JitterCompany/2401-mailbox-sensor/2401-pcb/design-calculations.xls

feedback resistor (Ohm) | 10000000 | 10M
wanted bandwidth (Hz) | 1000 | 1kHz
feedback capacitor (F) | 1.591549431e-11 | 15pF
photodiode capacitance (F) | 1.35e-10 | 23pF / 135pF
opamp input capacitance (F) | 1e-11 | estimate: 10pF
total input capacitance (F) | 1.45e-10
Opamp GBW required (Hz) | 10110.62 | Just > 10kHz !
