JitterCompany/2401-mailbox-sensor/2401-pcb/2401-pcb.xlsx

Sync | Ref | Qty | Value | Footprint | Description | MPN | Farnell | Mouser | required | stock | 3
1 | BT1, | 1 | SMTU 2450N-1-LF | Jitter_Footprints:BatteryHolder_SMTU-2450N-1-LF_1x2450 | Single-cell battery | SMTU 2450N-1-LF | 1216356 |  | 3
1 | C5, | 1 | 10uF | Capacitor_SMD:CP_Elec_4x5.4 | Polarized capacitor, small US symbol | MCVKZ035M100DA1L | 2611336 |  | 3
1 | C10, C17, | 2 | 15pF | Capacitor_SMD:C_0603_1608Metric | Unpolarized capacitor, small symbol |  | 721980 |  | 6
1 | C12, C11, C13, C2, C23, | 5 | 4.7uF | Capacitor_SMD:C_0805_2012Metric | Unpolarized capacitor, small symbol |  | 2611942 |  | 15
1 | C15, C14, C19, C24, C1, C6, C21, C22, C20, C16, C18, C7, C3, C4, C8, C9, | 16 | 100nF | Capacitor_SMD:C_0603_1608Metric | Unpolarized capacitor, small symbol |  | 2821266 |  | 48
1 | D1, | 1 | SFH2716 | Diode_SMD:D_0805_2012Metric | Photodiode | SFH 2716 | 2981722 |  | 3
1 | D2, | 1 | SFH2440 | OptoDevice:Osram_SMD-DIL2_4.5x4.0mm | Silicon Photodiode with V? Characteristic, SMD package | SFH 2440 | 2981709 |  | 3
1 | D3, | 1 | Red | LED_SMD:LED_0805_2012Metric | Light emitting diode | KPT-2012EC | 2099236 |  | 3
1 | D4, | 1 | Green | LED_SMD:LED_0805_2012Metric | Light emitting diode | KP-2012LSGC | 2463991 |  | 3
1 | J1, | 1 | Load Cell | Jitter_Footprints:JST_PH_S4B-PH-SM4-TB_1x04-1MP_P2.00mm_Horizontal | Generic connectable mounting pin connector, single row, 01x04, script generated (kicad-library-utils/schlib/autogen/connector/) | S4B-PH-SM4-TB(LF)(SN) | 9492631 |  | 0 | 8
1 | J2, | 1 | JTAG/SWD | Jitter_Footprints:connector_jtag_10pin_shrouded | Cortex Debug Connector, standard ARM Cortex-M SWD and JTAG interface | 20021521-00010T1LF |  |  | 0 | 100
1 | J3, | 1 | Conn_01x04_Male | Connector_PinHeader_2.54mm:PinHeader_1x04_P2.54mm_Vertical | Generic connector, single row, 01x04, script generated (kicad-library-utils/schlib/autogen/connector/) |  |  |  | 0 | 20
1 | Q1, | 1 | SFH3710(-Z) | Diode_SMD:D_0805_2012Metric_Pad1.15x1.40mm_HandSolder | NPN phototransistor, collector/emitter | SFH3710-Z | 2981749 |  | 3 |  | 2 versies van deze phototransistor: evt vergelijken
1 | Q2, | 1 | SFH3710 | Diode_SMD:D_0805_2012Metric_Pad1.15x1.40mm_HandSolder | NPN phototransistor, collector/emitter | SFH3710 | 1573490 |  | 3
1 | R2, R1, R6, R14, | 4 | 10M | Resistor_SMD:R_0805_2012Metric_Pad1.15x1.40mm_HandSolder | Resistor |  | 2447555 |  | 12
1 | R7, R8, | 2 | 4k7 | Resistor_SMD:R_0805_2012Metric_Pad1.15x1.40mm_HandSolder | Resistor |  | 2447672 |  | 6
1 | R9, R10, R4, R3, | 4 | 47k | Resistor_SMD:R_0805_2012Metric_Pad1.15x1.40mm_HandSolder | Resistor |  | 2447664 |  | 12
1 | R11, R12, | 2 | 150 | Resistor_SMD:R_0805_2012Metric_Pad1.15x1.40mm_HandSolder | Resistor |  | 2447574 |  | 6
1 | R13, R15, | 2 | 0 | Resistor_SMD:R_0805_2012Metric_Pad1.15x1.40mm_HandSolder | Resistor |  | 9333681 |  | 6
1 | RV1, | 1 | 100Ω | Potentiometer_SMD:Potentiometer_Bourns_3314J_Vertical | Potentiometer | 3314J-2-101E | 2328505 |  | 3
1 | RV2, | 1 | 100KΩ | Potentiometer_SMD:Potentiometer_Bourns_3314J_Vertical | Potentiometer | 3314J-2-104E | 2328506 |  | 3
1 | SW1, | 1 | SW_SPDT | Jitter_Footprints:slide_switch_09.03201.02 | Switch, single pole double throw | 09.03201.02 | 1608080 |  | 3
1 | U1, | 1 | LIS3DHTR | Package_LGA:LGA-16_3x3mm_P0.5mm_LayoutBorder3x5y | 3-Axis Accelerometer, 2/4/8/16g range, I2C/SPI interface, LGA-16 | LIS3DHTR | 2253507 | 511-LIS3DHTR | 3
1 | U2, | 1 | VL6180X | Jitter_Footprints:VL6180X | Proximity and ambient light sensing (ALS) module | VL6180XV0NR/1 | 2462820 |  | 3
1 | U3, | 1 | INA126 | Package_SO:VSSOP-8_3.0x3.0mm_P0.65mm |  | INA126E | 3004490 |  | 3
1 | U5, | 1 | DPS422 | Package_LGA:Bosch_LGA-8_2x2.5mm_P0.65mm_ClockwisePinNumbering | Barometric pressure & temp sensor | DPS422XTSA1 | 2986299 |  | 3
1 | U7, | 1 | TLV70228_SOT23-5 | Package_TO_SOT_SMD:SOT-23-5 | 300mA Low Dropout Voltage Regulator, Fixed Output 2.8V, SOT-23-5 | TLV70228DBVT | 2492371 |  | 3
1 | U8, | 1 | STM32G070KBT6 | Package_QFP:LQFP-32_7x7mm_P0.8mm | ARM Cortex-M0+ MCU, 128KB flash, 36KB RAM, 64MHz, 2.0-3.6V, 29 GPIO, LQFP-32 ARM Cortex-M0 MCU, 64KB flash, 8KB RAM, 48MHz, 2.4-3.6V, 39 GPIO, LQFP-48 | STM32G070KBT6 | 3365394 | 511-STM32G070KBT6 | 3
1 | U9, | 1 | AT25SF641-SUB-T | Package_SO:SOIC-8_3.9x4.9mm_P1.27mm | 64-Mbit, 2.5V Minimum SPI Serial Flash Memory with Dual-I/O and Quad-I/O Support, SOIC-8 | AT25SF641-SUB-T | 2988514 |  | 3
1 | U11, U6, U10, U4, | 4 | MCP6001U | Package_TO_SOT_SMD:SOT-23-5 | 1MHz, Low-Power Op Amp, SOT-23-5 | MCP6001U | 8540845 |  | 12
