JitterCompany/2401-mailbox-sensor/2401-pcb/2401-pcb.kicad_pcb

## KiCad design 2401-pcb/2401-pcb.kicad_pcb (2020-06-11)

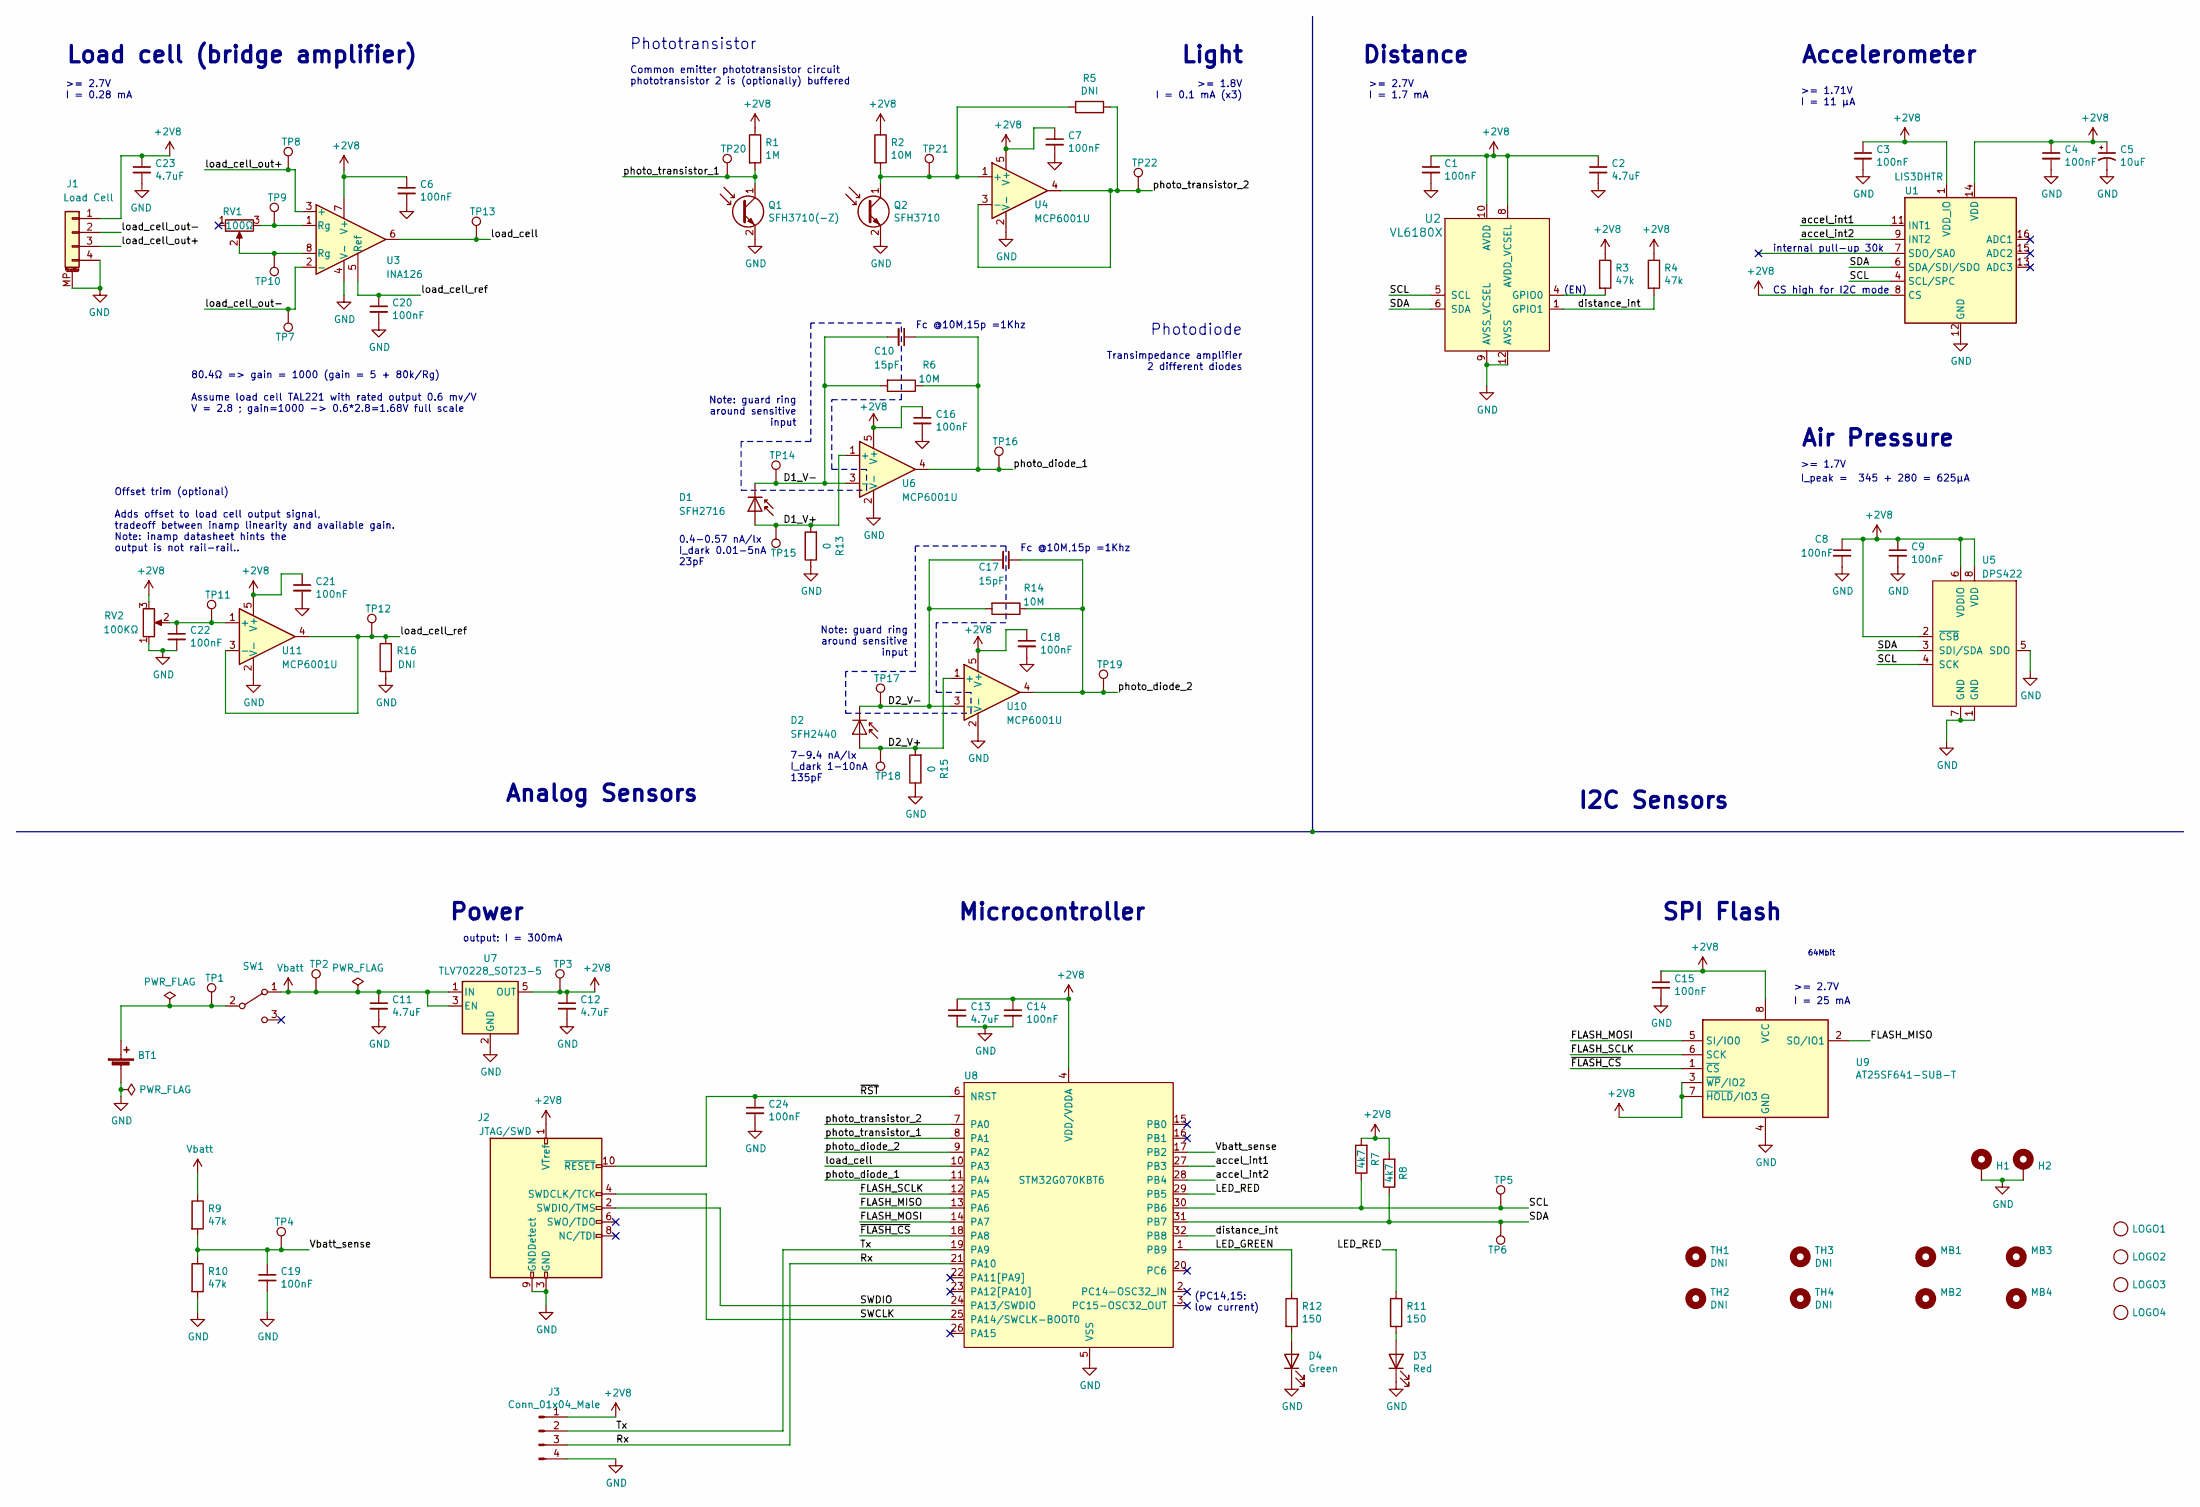
[picture p1: schematic 2401-pcb.sch, 2401 - Brievenbus sensor]

Parts:
BT1: SMTU 2450N-1-LF; BatteryHolder_SMTU-2450N-1-LF_1x2450; MPN SMTU 2450N-1-LF; Farnell 1216356
C1, C3, C4, C6, C7, C8, C9, C14, C15, C16, C18, C19, C20, C21, C22, C24: 100nF; C_0603_1608Metric
C2, C11, C12, C13, C23: 4.7uF; C_0805_2012Metric
C5: 10uF; CP_Elec_4x5.4; MPN MCVKZ035M100DA1L; Farnell 2611336
C10, C17: 15pF; C_0603_1608Metric
D1: SFH2716; D_0805_2012Metric; MPN SFH 2716; Farnell 2981722
D2: SFH2440; Osram_SMD-DIL2_4.5x4.0mm; MPN SFH 2440; Farnell 2981709
D3: Red; LED_0805_2012Metric; MPN KPT-2012EC; Farnell 2099236
D4: Green; LED_0805_2012Metric; MPN KP-2012LSGC; Farnell 2463991
H1, H2: DNI; MountingHole_4.5mm_Pad_Via
J1: Load Cell; JST_PH_S4B-PH-SM4-TB_1x04-1MP_P2.00mm_Horizontal; MPN S4B-PH-SM4-TB(LF)(SN); Farnell 9492631
J2: JTAG/SWD; connector_jtag_10pin_shrouded; MPN 20021521-00010T1LF
J3: Conn_01x04_Male; PinHeader_1x04_P2.54mm_Vertical
LOGO1, LOGO3: DNI; Jitter
LOGO2, LOGO4: DNI; Symbol_Jitter-Icon_CopperAndSilkScreenTop
MB1, MB2, MB3, MB4: DNI; MouseBite_3.5mmx2.2mm_breakaway
Q1: SFH3710(-Z); D_0805_2012Metric_Pad1.15x1.40mm_HandSolder; MPN SFH3710-Z; Farnell 2981749
Q2: SFH3710; D_0805_2012Metric_Pad1.15x1.40mm_HandSolder; MPN SFH3710; Farnell 1573490
R1: 1M; R_0805_2012Metric_Pad1.15x1.40mm_HandSolder
R2, R6, R14: 10M; R_0805_2012Metric_Pad1.15x1.40mm_HandSolder
R3, R4, R9, R10: 47k; R_0805_2012Metric_Pad1.15x1.40mm_HandSolder
R5, R16: DNI; R_0805_2012Metric_Pad1.15x1.40mm_HandSolder
R7, R8: 4k7; R_0805_2012Metric_Pad1.15x1.40mm_HandSolder
R11, R12: 150; R_0805_2012Metric_Pad1.15x1.40mm_HandSolder
R13, R15: 0; R_0805_2012Metric_Pad1.15x1.40mm_HandSolder
RV1: 100Ω; Potentiometer_Bourns_3314J_Vertical; MPN 3314J-2-101E; Farnell 2328505
RV2: 100KΩ; Potentiometer_Bourns_3314J_Vertical; MPN 3314J-2-104E; Farnell 2328506
SW1: SW_SPDT; slide_switch_09.03201.02; MPN 09.03201.02; Farnell 1608080
TH1, TH2, TH3, TH4: DNI; Tooling_hole_4.1mm_aisler
TP1, TP2, TP3, TP4, TP5, TP6, TP7, TP8, TP9, TP10, TP11, TP12, TP13, TP15, TP16, TP18, TP19, TP20, TP21, TP22: DNI; TestPoint_THTPad_D1.0mm_Drill0.5mm
TP14, TP17: DNI; TestPoint_Pad_D1.0mm
U1: LIS3DHTR; LGA-16_3x3mm_P0.5mm_LayoutBorder3x5y; MPN LIS3DHTR; Mouser 511-LIS3DHTR
U2: VL6180X; MPN VL6180XV0NR/1; Farnell 2462820
U3: INA126; VSSOP-8_3.0x3.0mm_P0.65mm; MPN INA126E; Farnell 3004490
U4, U6, U10, U11: MCP6001U; SOT-23-5; MPN MCP6001U; Farnell 8540845
U5: DPS422; Bosch_LGA-8_2x2.5mm_P0.65mm_ClockwisePinNumbering; MPN DPS422XTSA1; Farnell 2986299
U7: TLV70228_SOT23-5; SOT-23-5; MPN TLV70228DBVT; Farnell 2492371
U8: STM32G070KBT6; LQFP-32_7x7mm_P0.8mm; MPN STM32G070KBT6; Mouser 511-STM32G070KBT6
U9: AT25SF641-SUB-T; SOIC-8_5.275x5.275mm_P1.27mm; MPN AT25SF641-SUB-T; Farnell 2988514

Connections:
+2V8: C1.1, C2.1, C3.1, C4.1, C5.1, C6.1, C7.1, C8.1, C9.1, C12.1, C13.1, C14.1, C15.1, C16.1, C18.1, C21.1, C23.1, J1.1, J2.1 (VTref), J3.1, R1.1, R2.1, R3.1, R4.1, R7.2, R8.2, RV2.3, TP3.1, U1.1 (VDD_IO), U1.8 (CS), U1.14 (VDD), U2.8 (AVDD_VCSEL), U2.10 (AVDD), U3.7 (V+), U4.5 (V+), U5.2 (~CSB), U5.6 (VDDIO), U5.8 (VDD), U6.5 (V+), U7.5 (OUT), U8.4 (VDD/VDDA), U9.3 (~WP~/IO2), U9.7 (~HOLD~/IO3), U9.8 (VCC), U10.5 (V+), U11.5 (V+)
/D1_V+: D1.2 (A), R13.2, TP15.1, U6.1 (+)
/D1_V-: C10.2, D1.1 (K), R6.2, TP14.1, U6.3 (-)
/D2_V+: D2.2 (A), R15.2, TP18.1, U10.1 (+)
/D2_V-: C17.2, D2.1 (K), R14.2, TP17.1, U10.3 (-)
/FLASH_MISO: U8.13 (PA6), U9.2 (SO/IO1)
/FLASH_MOSI: U8.14 (PA7), U9.5 (SI/IO0)
/FLASH_SCLK: U8.12 (PA5), U9.6 (SCK)
/LED_GREEN: R12.1, U8.1 (PB9)
/LED_RED: R11.1, U8.29 (PB5)
/Rx: J3.3, U8.21 (PA10)
/SCL: R7.1, TP5.1, U1.4 (SCL/SPC), U2.5 (SCL), U5.4 (SCK), U8.30 (PB6)
/SDA: R8.1, TP6.1, U1.6 (SDA/SDI/SDO), U2.6 (SDA), U5.3 (SDI/SDA), U8.31 (PB7)
/SWCLK: J2.4 (SWDCLK/TCK), U8.25 (PA14/SWCLK-BOOT0)
/SWDIO: J2.2 (SWDIO/TMS), U8.24 (PA13/SWDIO)
/Tx: J3.2, U8.19 (PA9)
/Vbatt_sense: C19.1, R9.2, R10.1, TP4.1, U8.17 (PB2)
/accel_int1: U1.11 (INT1), U8.27 (PB3)
/accel_int2: U1.9 (INT2), U8.28 (PB4)
/distance_int: R4.2, U2.1 (GPIO1), U8.32 (PB8)
/load_cell: TP13.1, U3.6, U8.10 (PA3)
/load_cell_out+: J1.3, TP8.1, U3.3 (+)
/load_cell_out-: J1.2, TP7.1, U3.2 (-)
/load_cell_ref: C20.1, R16.2, TP12.1, U3.5 (Ref), U11.3 (-), U11.4
/photo_diode_1: C10.1, R6.1, TP16.1, U6.4, U8.11 (PA4)
/photo_diode_2: C17.1, R14.1, TP19.1, U8.9 (PA2), U10.4
/photo_transistor_1: Q1.1 (C), R1.2, TP20.1, U8.8 (PA1)
/photo_transistor_2: R5.1, TP22.1, U4.3 (-), U4.4, U8.7 (PA0)
/~FLASH_CS: U8.18 (PA8), U9.1 (~CS)
/~RST: C24.1, J2.10 (~RESET~), U8.6 (NRST)
GND: BT1.2 (-), C1.2, C2.2, C3.2, C4.2, C5.2, C6.2, C7.2, C8.2, C9.2, C11.2, C12.2, C13.2, C14.2, C15.2, C16.2, C18.2, C19.2, C20.2, C21.2, C22.2, C23.2, C24.2, D3.1 (K), D4.1 (K), H1.1, H2.1, J1.4, J1.MP (MountPin), J2.3 (GND), J2.5 (GND), J2.9 (GNDDetect), J3.4, Q1.2 (E), Q2.2 (E), R10.2, R13.1, R15.1, R16.1, RV2.1, U1.5 (GND), U1.10 (GND), U1.12 (GND), U2.9 (AVSS_VCSEL), U2.12 (AVSS), U3.4 (V-), U4.2 (V-), U5.1 (GND), U5.5 (SDO), U5.7 (GND), U6.2 (V-), U7.2 (GND), U8.5 (VSS), U9.4 (GND), U10.2 (V-), U11.2 (V-)
unnamed: BT1.1 (+), SW1.2 (B), TP1.1
unnamed: C22.1, RV2.2, TP11.1, U11.1 (+)
unnamed: D3.2 (A), R11.2
unnamed: D4.2 (A), R12.2
unnamed: Q2.1 (C), R2.2, R5.2, TP21.1, U4.1 (+)
unnamed: R3.2, U2.4 (GPIO0)
unnamed: RV1.2, TP10.1, U3.8 (Rg)
unnamed: RV1.3, TP9.1, U3.1 (Rg)
Vbatt: C11.1, R9.1, SW1.1 (A), TP2.1, U7.1 (IN), U7.3 (EN)

Notes on the sheet:
SPI Flash
64Mbit
>= 2.7V
I = 25 mA
Power
output: I = 300mA
Microcontroller
(PC14,15: low current)
(EN)
I2C Sensors
>= 2.7V I = 1.7 mA
Distance
Load cell (bridge amplifier)
80.4Ω => gain = 1000 (gain = 5 + 80k/Rg) Assume load cell TAL221 with rated output 0.6 mv/V V = 2.8 ; gain=1000 -> 0.6*2.8=1.68V full scale
Offset trim (optional) Adds offset to load cell output signal, tradeoff between inamp linearity and available gain. Note: inamp datasheet hints the output is not rail-rail..
>= 2.7V I = 0.28 mA
Light
Phototransistor
Photodiode
Common emitter phototransistor circuit phototransistor 2 is (optionally) buffered
Analog Sensors
7-9.4 nA/lx I_dark 1-10nA 135pF
0.4-0.57 nA/lx I_dark 0.01-5nA 23pF
Fc @10M,15p =1Khz
Transimpedance amplifier 2 different diodes
>= 1.8V I = 0.1 mA (x3)
Note: guard ring around sensitive input
Accelerometer
internal pull-up 30k
CS high for I2C mode
>= 1.71V I = 11 µA
I_peak = 345 + 280 = 625µA
>= 1.7V
Air Pressure

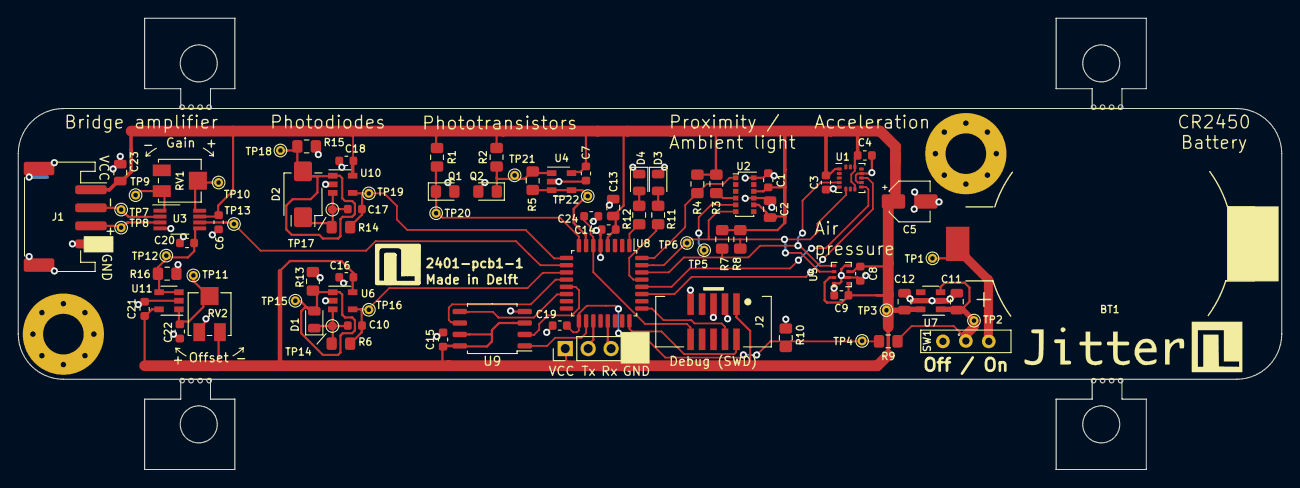
[picture p2: board 2401-pcb.kicad_pcb from above]

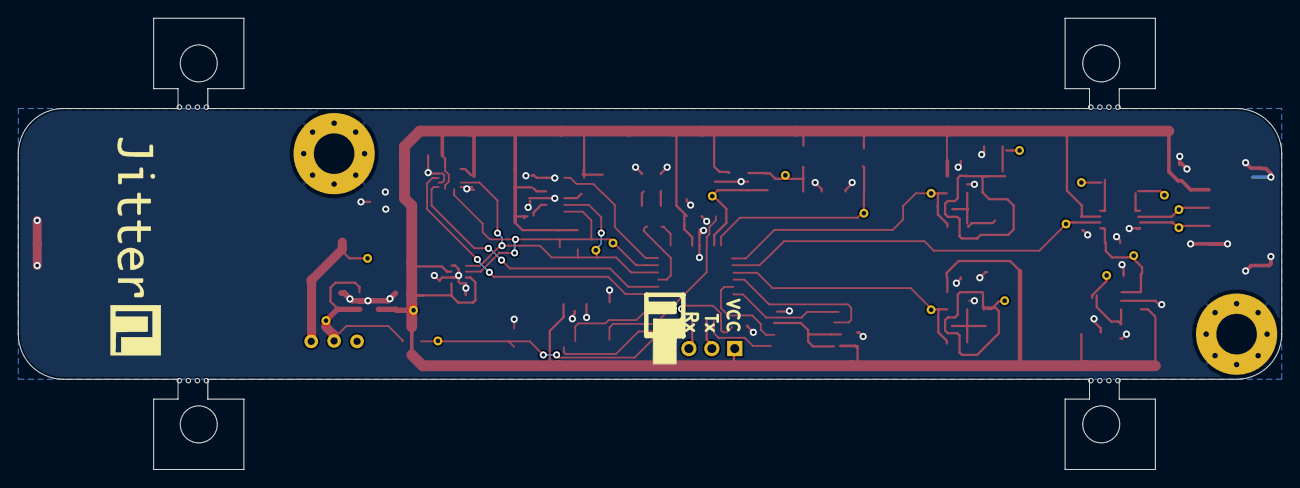
[picture p3: board 2401-pcb.kicad_pcb from below]

Board: 2 copper layers, 140.0 x 50.0 mm, 100 parts (2 on the bottom side), 40 nets.
