JitterCompany/2401-mailbox-sensor/(commit log)

2020-01-17 Add pcb directory (WIP)
    [2401-pcb.kicad_pcb, 2401-pcb.sch]
2020-01-27 Improve schematics
    [2401-pcb.kicad_pcb, 2401-pcb.sch]
2020-01-27 Schematics: finish photodiode circuit
    The design calculations are in the xls file.
    [2401-pcb.sch, design-calculations.xls]
2020-01-27 PCB: assign/fix footprints + 3D
    [2401-pcb.kicad_pcb]
2020-01-28 PCB: routing is more or less done
    The KiCAD DRC passes, but it is not checked againts the Jitter
    Checklist..
    [2401-pcb.kicad_pcb, 2401-pcb.sch]
2020-01-29 Add pinmapping sheet
    [pinMapping_stm32g070cb.xlsx]
2020-01-29 Schematics: reorder to similar layout as PCB
    [2401-pcb.sch]
2020-01-29 Update pinmapping sheet from schematics
    [pinMapping_stm32g070cb.xlsx]
2020-01-29 Schematics: remap LED pins: PC13-15 are low-current only
    [2401-pcb.kicad_pcb, 2401-pcb.sch, pinMapping_stm32g070cb.xlsx]
2020-01-29 PCB: schematics & layout complete [Checklist PASS]
    [2401-pcb.kicad_pcb, 2401-pcb.sch]
2020-01-30 PCB/Schematic bugfix: add NRST capacitor, update air pressure symbol
    [2401-pcb.kicad_pcb, 2401-pcb.sch]
2020-01-30 Schematics: don't reference rescue library
    [2401-pcb.sch]
2020-01-30 Add jitter schematic template to repo
2020-02-05 PCB: export V1 layout
    [2401-pcb.kicad_pcb]
2020-02-10 PCB: add Final production BOM
    [2401-pcb.sch, 2401-pcb.xlsx]
2020-02-10 PCB: last BOM update before ordering
    [2401-pcb.xlsx]
2020-03-14 Add blinky project for pcb1
2020-03-14 Try to create a board support crate
2020-03-18 Add peripheral verification firmware
    tests for i2c and spi devices.
2020-05-12 Start sensorlogger firmware using shared-bus (for sharing i2c)
2020-05-12 Add vl6180 and lis3dh i2c sensors to sensorlogger
2020-05-12 Add adc sensors
2020-05-12 Remove VTemp internal temperature sensor as it is unnecessary
2020-05-19 Start with spi log storage engine. Syntax is ok now.
2020-05-20 basic storage engine is working
    Write packets with prefix. Search for prefix bytes at fixed offsets to
    find next address for writing (after reset).
    Edge cases not handled yet. Such as writing accross page boundaries.
    [log_storage.rs, main.rs, sensors.rs]
2020-05-22 Small benchmark shows that writing fails after first block of 256 bytes
    The flash automatically wraps to the first byte of the current page. so
    we need to make sure we do not cross that boundary and issue a new write
    command for the remaining bytes.
    [log_storage.rs, main.rs, sensors.rs]
2020-05-22 Implement custom error type with from trait implemented
    [log_storage.rs, main.rs, sensors.rs]
2020-05-23 Implement reading sensor data from spi memory
2020-05-24 Fix i2c issues with newest stm32g0xx-hal version
    [main.rs]
2020-05-24 Handle flash full error; print message on uart.
    Also turn on led1 while writing to flash to indicate to not turn off the
    board.
    [main.rs]
2020-05-29 Add use_flash feature to toggle on/off spi flash during compile time
2020-06-02 Implement correcting adc for current vdd value
    [main.rs]
2020-06-03 Use ptr::read_volatile to read VREFINT calibration value
2020-06-08 Add panc handler with blink and fix sensor size
    bool = 1 byte
    [main.rs, sensors.rs]
2020-06-11 Changes for production at aisler
    [2401-pcb.kicad_pcb, 2401-pcb.sch]
2020-06-11 PCb changes
    [2401-pcb.kicad_pcb, 2401-pcb.sch]
2020-06-18 Improve flow of code to prevent unnecessary delays
    When triggered we don't want delays that can make us miss the detection.
    [main.rs]
